dienikolai/attiny84-pwm-01/README.md

Praktisches Beispiel zur Nutzung der PWM des ATTiny84

Dieses Projekt steht unter GPL-Lizenz
