dienikolai/attiny84-pwm-01/(list of files, drawings)

Other design files:
weihnacht.fzz
